unsurv/NFC_temp/README.md

# NFC_sense

available [here](https://shop.unsurv.org/)
