unsurv/NFC_temp/software/nfc_sense/old2/README.md

# RF430CL
Energia/Arduino library for TI RF430CL330H NFC Passive Tag
