unsurv/NFC_temp/hardware/nfc_sense_ntag/nfc_sense_ntag.png

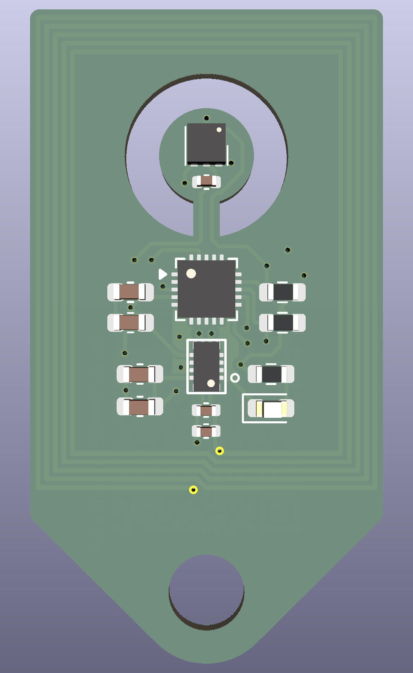
hardware/nfc_sense_ntag/nfc_sense_ntag.png
