unsurv/NFC_temp/hardware/nfc_sense_ntag/nfc_sense_ntag_custom_view.png

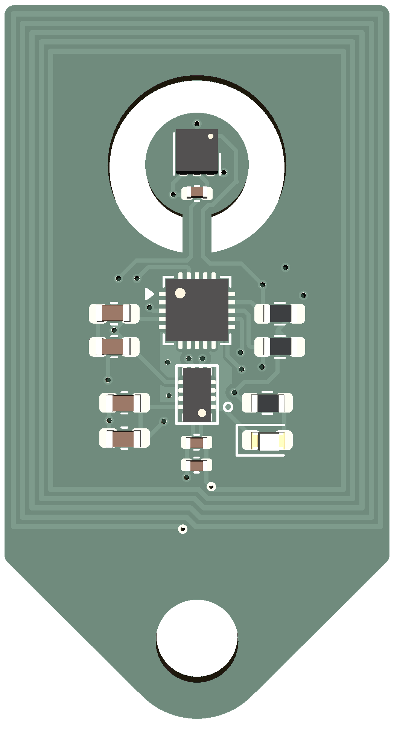
hardware/nfc_sense_ntag/nfc_sense_ntag_custom_view.png
