unsurv/NFC_temp/hardware/tools/nfc_sense_prgramming/case/nfc_sense.png

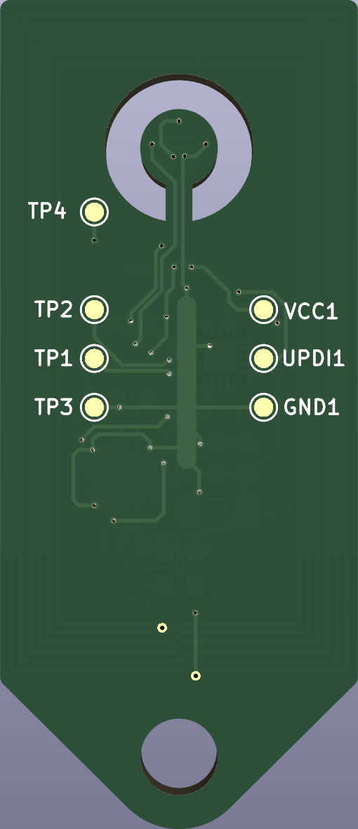
hardware/tools/nfc_sense_prgramming/case/nfc_sense.png
