unsurv/NFC_temp/software/arduino_settings.PNG

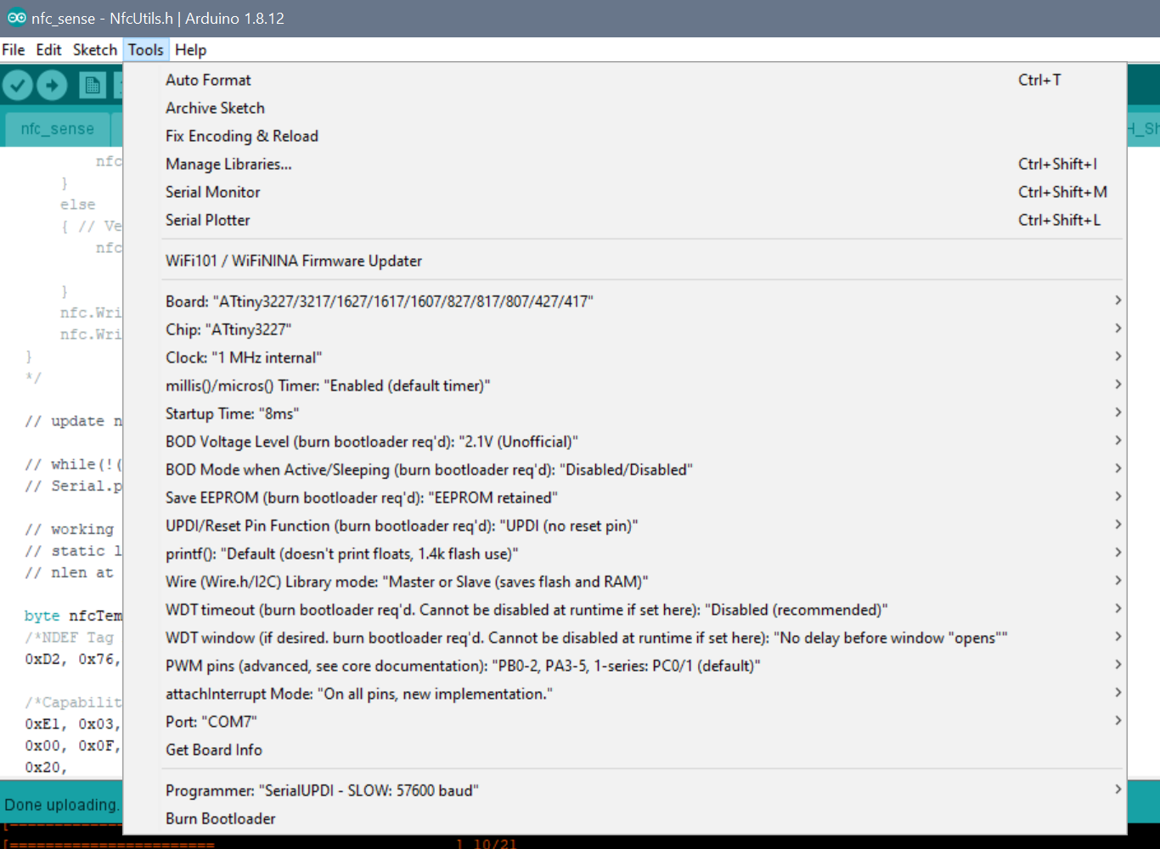
software/arduino_settings.PNG
