unsurv/NFC_temp/hardware/tools/debug/3D/pocket_knife_scales-pocket_knife_uppermain.stl

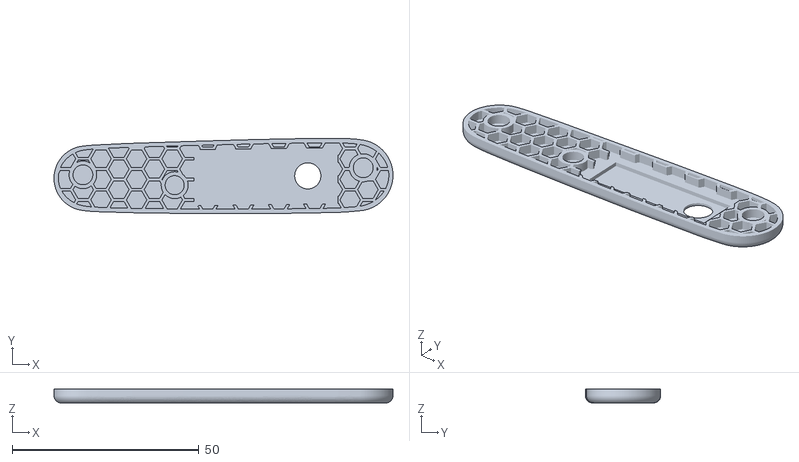
[picture p5: CAD file, 2025-08-21]
hardware/tools/debug/3D/pocket_knife_scales-pocket_knife_uppermain.stl
90.7 x 20.2 x 3.75
