unsurv/NFC_temp/hardware/case/nfc_case_simple_ntag.FCStd

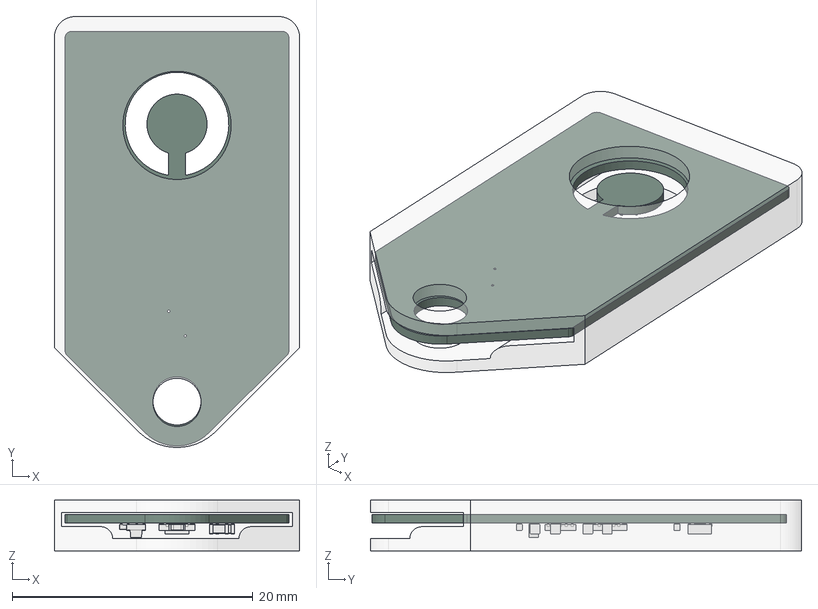
[picture p6: CAD file, 2026-08-13]
hardware/case/nfc_case_simple_ntag.FCStd
20.4 x 35.8 x 4.20 mm
simple_case
C_0603_1608Metric018
C_0603_1608Metric020
C_0603_1608Metric022
WSON_6_1EP_2x2mm_P065mm_EP1x16mm002
LED_0603_1608Metric002
UQFN-20-1EP_3x3mm_Pitch0.4mm001
R_0603_1608Metric012
C_0402_1005Metric010
UDFN_10_135x26mm_Pitch05mm
C_0402_1005Metric012
R_0603_1608Metric014
R_0603_1608Metric016
C_0603_1608Metric024
C_0402_1005Metric014
nfc_sense_ntag_PCB001
