unsurv/NFC_temp/hardware/nfc_pocket_knife/nfc_sense.step

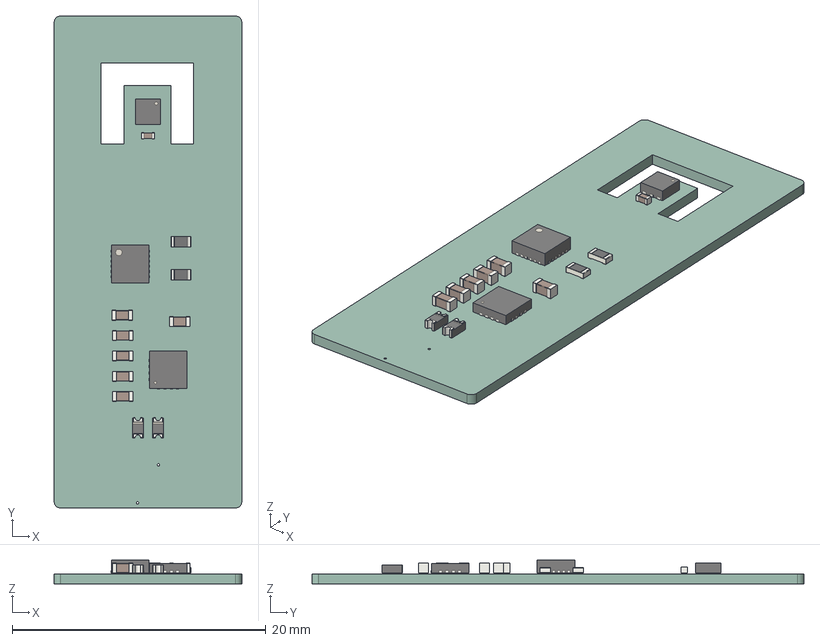
[picture p7: CAD file, 2025-06-03]
hardware/nfc_pocket_knife/nfc_sense.step
14.8 x 38.8 x 1.86 mm
C_0603_1608Metric x 6
QFN-16-1EP_3x3mm_P0.5mm_EP1.7x1.7mm
WSON_6_1EP_2x2mm_P065mm_EP1x16mm
QFN-24_3x3mm_Pitch0.4mm
D_0603 x 2
R_0603_1608Metric x 2
C_0402_1005Metric
victorinox_sense_PCB
