unsurv/NFC_temp/hardware/nfc_sense_attiny/nfc_sense.step

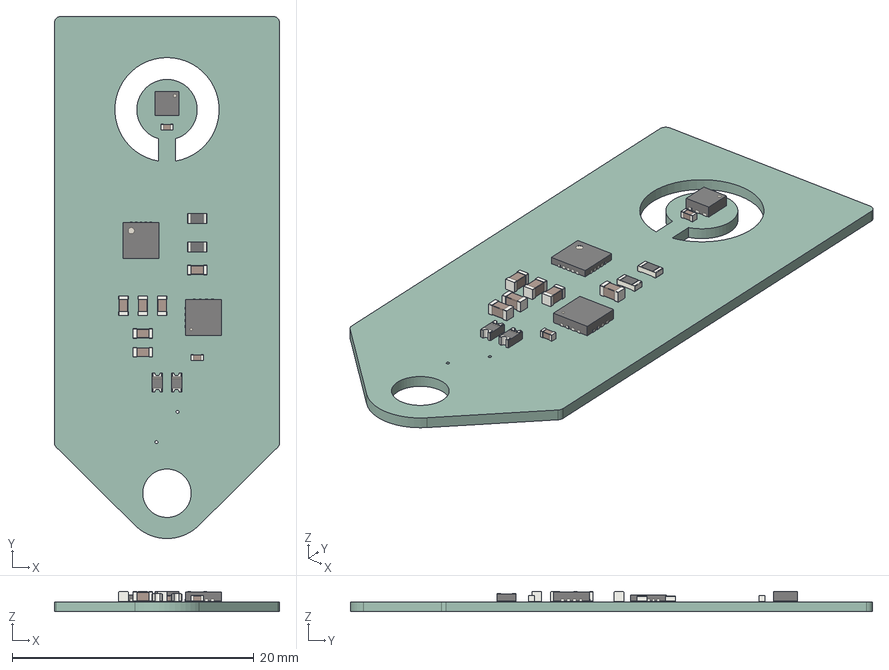
[picture p8: CAD file, 2024-11-09]
hardware/nfc_sense_attiny/nfc_sense.step
18.6 x 43.1 x 1.66 mm
C_0603_1608Metric x 6
QFN-16-1EP_3x3mm_P0.5mm_EP1.7x1.7mm
WSON_6_1EP_2x2mm_P065mm_EP1x16mm
UQFN-20-1EP_3x3mm_Pitch0.4mm
D_0603 x 2
R_0603_1608Metric x 2
C_0402_1005Metric x 2
nfc_sense_PCB
