unsurv/NFC_temp/hardware/nfc_sense_ntag/nfc_sense_ntag.step

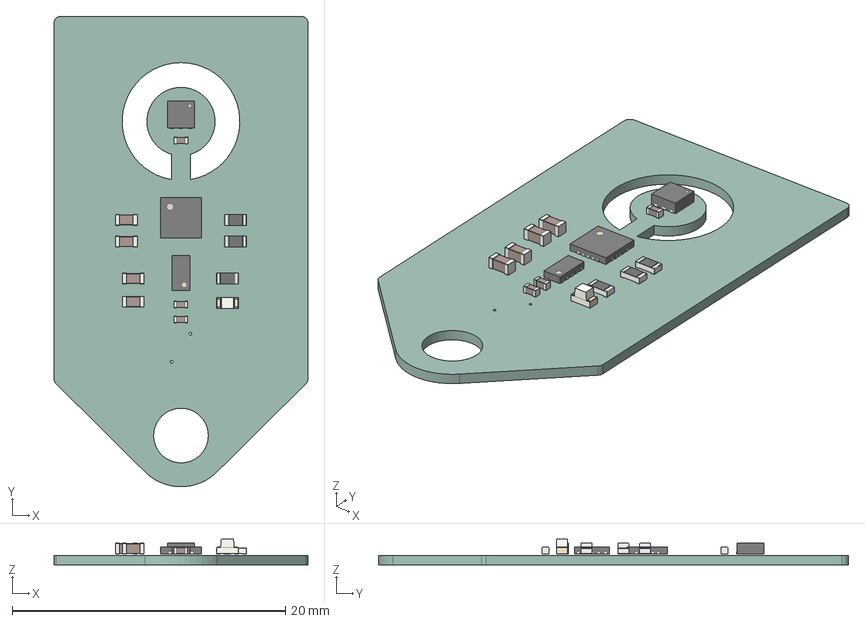
[picture p9: CAD file, 2026-08-13]
hardware/nfc_sense_ntag/nfc_sense_ntag.step
18.6 x 34.4 x 1.90 mm
C_0603_1608Metric x 4
WSON_6_1EP_2x2mm_P065mm_EP1x16mm
LED_0603_1608Metric
UQFN-20-1EP_3x3mm_Pitch0.4mm
R_0603_1608Metric x 3
C_0402_1005Metric x 3
UDFN_10_135x26mm_Pitch05mm
nfc_sense_ntag_PCB
