unsurv/NFC_temp/hardware/nfc_sense_ntag_surface/nfc_sense_ntag_surface.step

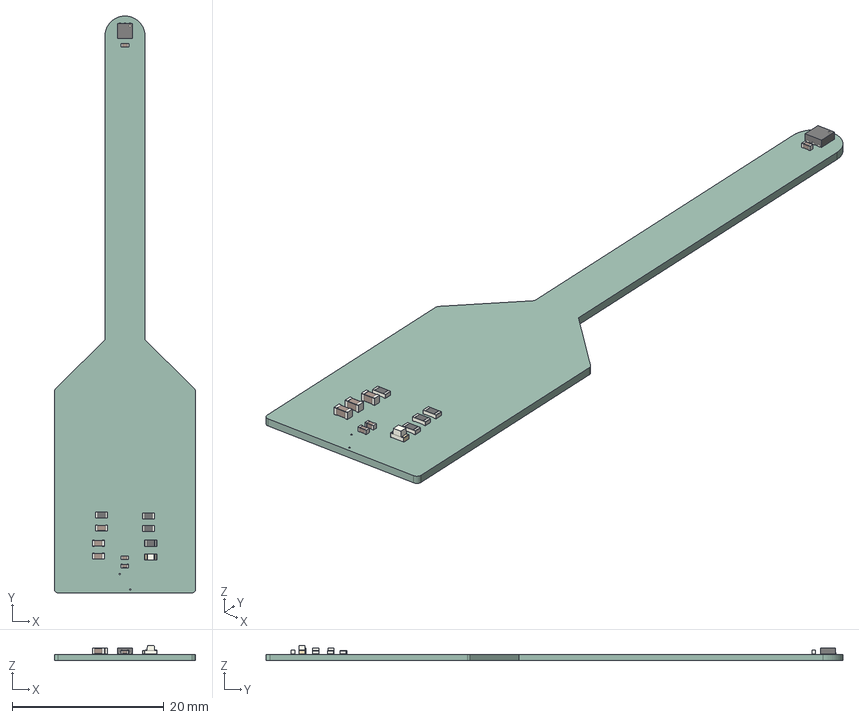
[picture p10: CAD file, 2025-11-26]
hardware/nfc_sense_ntag_surface/nfc_sense_ntag_surface.step
18.6 x 76.0 x 1.94 mm
C_0603_1608Metric x 3
WSON_6_1EP_2x2mm_P065mm_EP1x16mm
LED_0603_1608Metric
R_0603_1608Metric x 4
C_0402_1005Metric x 3
nfc_sense_ntag_surface_PCB
