unsurv/NFC_temp/hardware/tools/debug/3D/pocket_knife_scales.FCStd

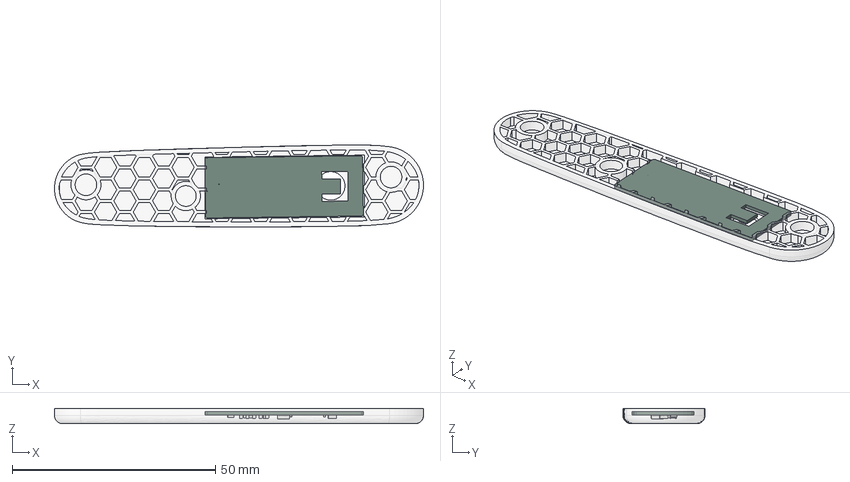
[picture p11: CAD file, 2025-09-21]
hardware/tools/debug/3D/pocket_knife_scales.FCStd
90.7 x 20.2 x 3.75 mm
main
C_0603_1608Metric012
C_0603_1608Metric014
C_0603_1608Metric016
C_0603_1608Metric018
QFN-16-1EP_3x3mm_P0.5mm_EP1.7x1.7mm002
WSON_6_1EP_2x2mm_P065mm_EP1x16mm001
C_0603_1608Metric020
QFN-24_3x3mm_Pitch0.4mm001
C_0603_1608Metric022
D_0605
R_0603_1608Metric004
C_0402_1005Metric002
R_0603_1608Metric006
D_0606
victorinox_sense_PCB001
