unsurv/NFC_temp/hardware/tools/nfc_sense_prgramming/case/programming_case_ntag.FCStd

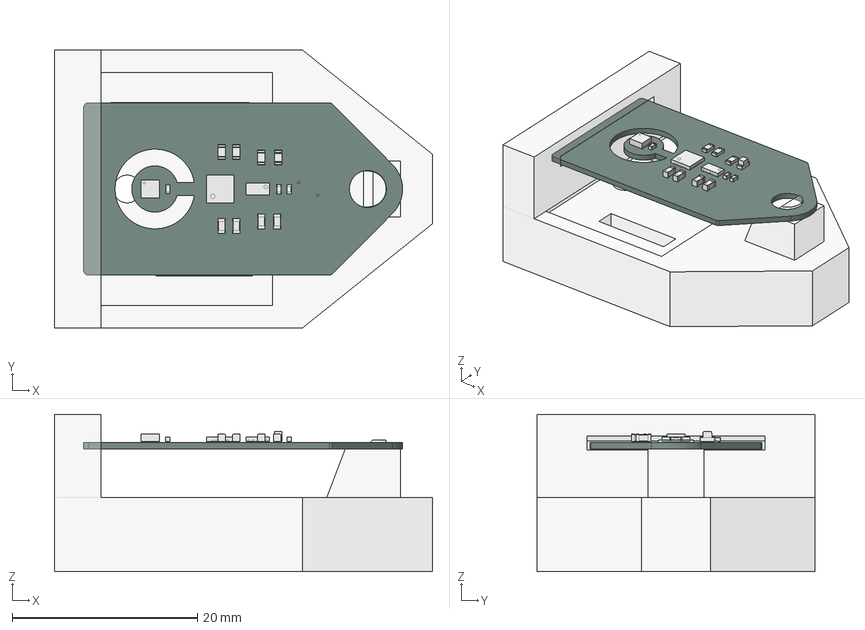
[picture p12: CAD file, 2026-08-11]
hardware/tools/nfc_sense_prgramming/case/programming_case_ntag.FCStd
40.8 x 30.0 x 17.0 mm
C_0603_1608Metric004
C_0603_1608Metric006
C_0603_1608Metric008
WSON_6_1EP_2x2mm_P065mm_EP1x16mm
LED_0603_1608Metric
UQFN-20-1EP_3x3mm_Pitch0.4mm
R_0603_1608Metric002
C_0402_1005Metric002
UDFN_10_135x26mm_Pitch05mm
C_0402_1005Metric004
R_0603_1608Metric004
R_0603_1608Metric006
C_0603_1608Metric010
C_0402_1005Metric006
nfc_sense_ntag_PCB
