unsurv/NFC_temp/hardware/tools/stencil_helper/stencil_spacer_machine.FCStd

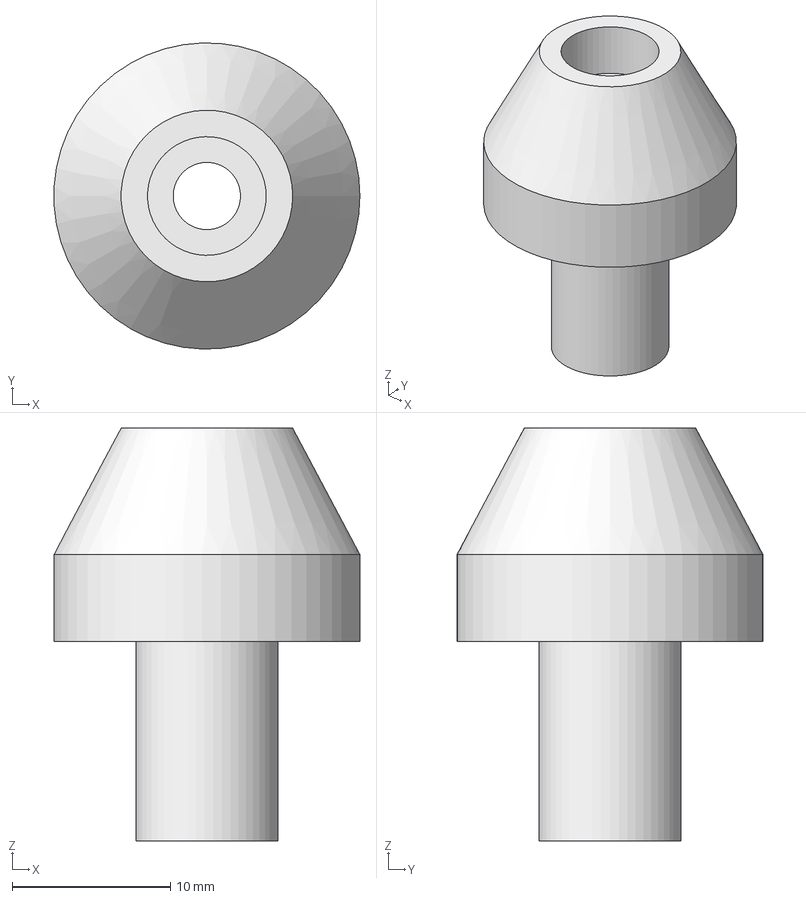
[picture p13: CAD file, 2026-08-11]
hardware/tools/stencil_helper/stencil_spacer_machine.FCStd
19.3 x 19.3 x 26.1 mm
