unsurv/NFC_temp/hardware/case/nfc_case_simple_ntag-simple_case.stl

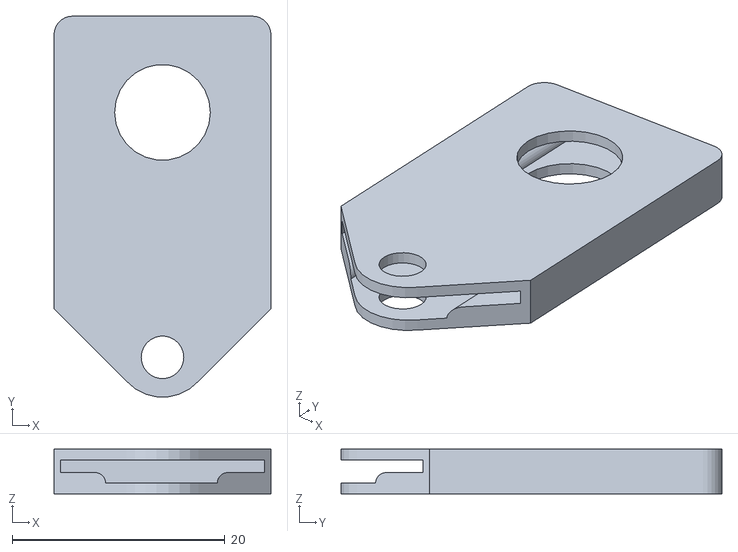
[picture p14: CAD file, 2026-08-13]
hardware/case/nfc_case_simple_ntag-simple_case.stl
20.4 x 35.8 x 4.20
