unsurv/NFC_temp/hardware/tools/nfc_sense_prgramming/case/programming_case_ntag-Body.stl

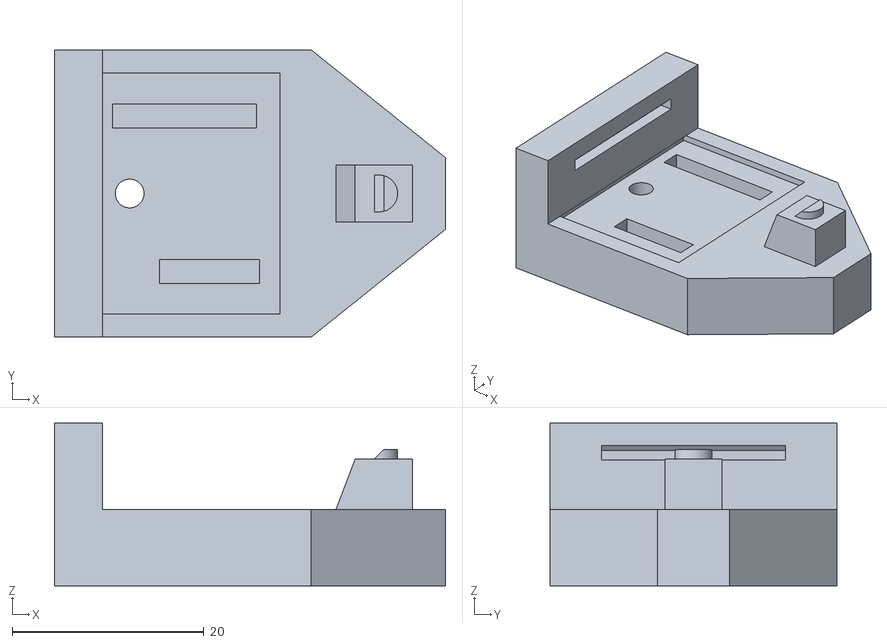
[picture p15: CAD file, 2026-08-11]
hardware/tools/nfc_sense_prgramming/case/programming_case_ntag-Body.stl
40.8 x 30.0 x 17.0
