unsurv/NFC_temp/hardware/tools/stencil_helper/stencil_spacers.FCStd

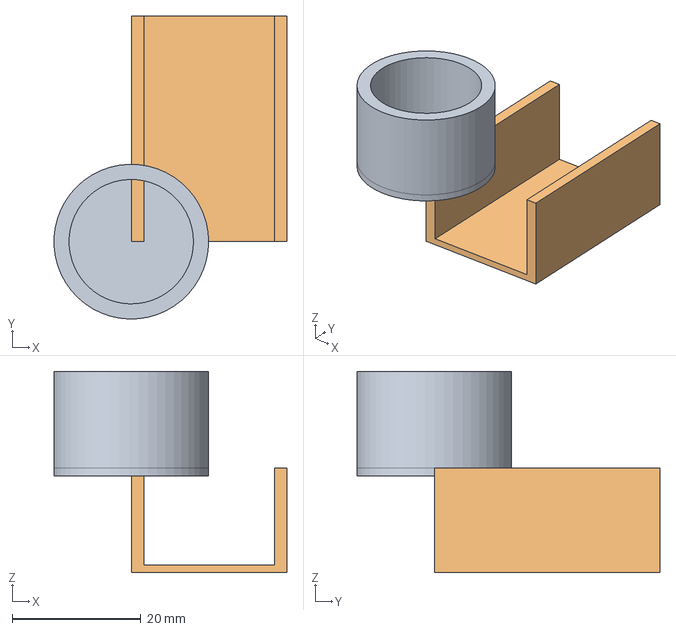
[picture p16: CAD file, 2026-08-11]
hardware/tools/stencil_helper/stencil_spacers.FCStd
36.1 x 47.0 x 31.2 mm
round_spacer
rect_spacer
