unsurv/NFC_temp/hardware/case/thermal_sleeve.FCStd

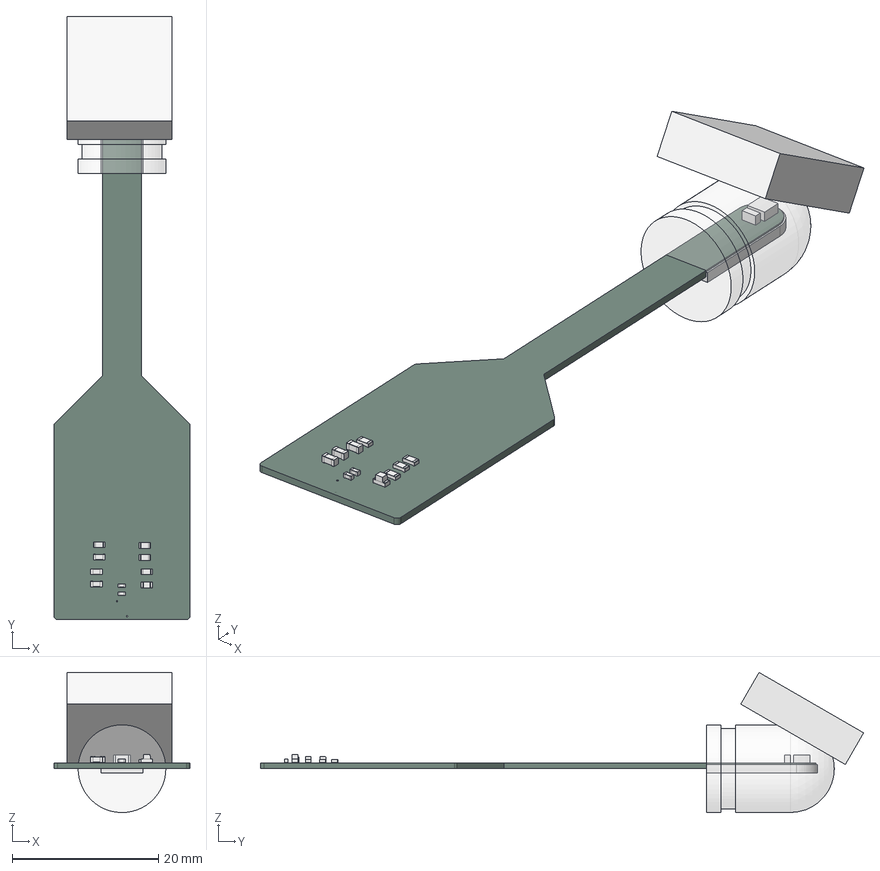
[picture p17: CAD file, 2025-11-26]
hardware/case/thermal_sleeve.FCStd
18.6 x 82.5 x 19.2 mm
temperature_sleeve
PCB_cutout
surface_edge
C_0603_1608Metric006
C_0603_1608Metric008
WSON_6_1EP_2x2mm_P065mm_EP1x16mm001
LED_0603_1608Metric002
R_0603_1608Metric008
C_0402_1005Metric006
R_0603_1608Metric010
C_0402_1005Metric008
R_0603_1608Metric012
R_0603_1608Metric014
C_0603_1608Metric010
C_0402_1005Metric010
nfc_sense_ntag_surface_PCB
