unsurv/NFC_temp/hardware/case/nfc_stand.FCStd

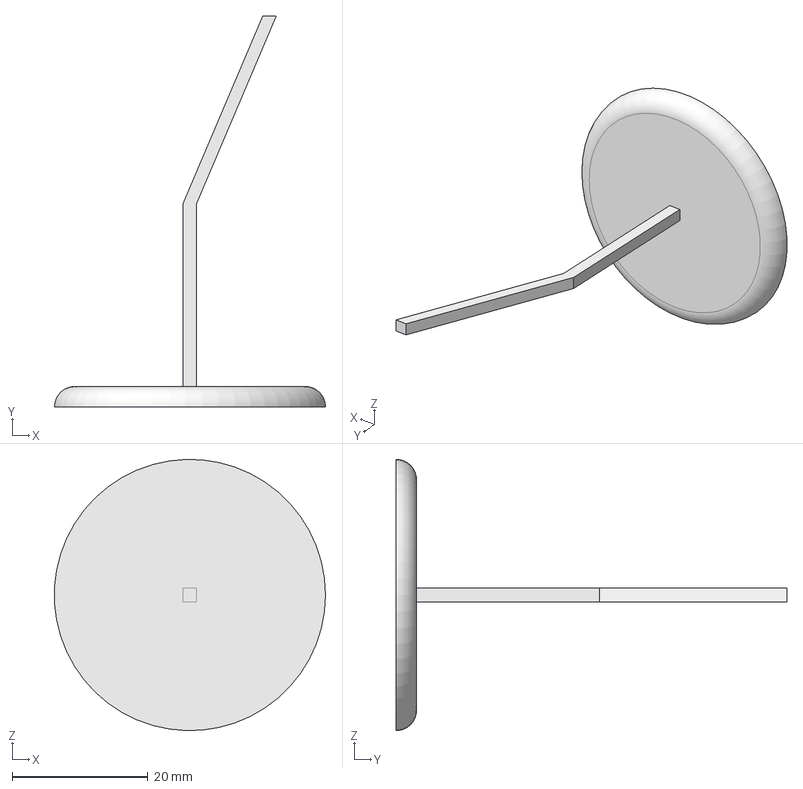
[picture p18: CAD file, 2025-08-21]
hardware/case/nfc_stand.FCStd
40.0 x 57.6 x 40.0 mm
