unsurv/NFC_temp/hardware/tools/nfc_sense_prgramming/case/programming_case_0_8mm.FCStd

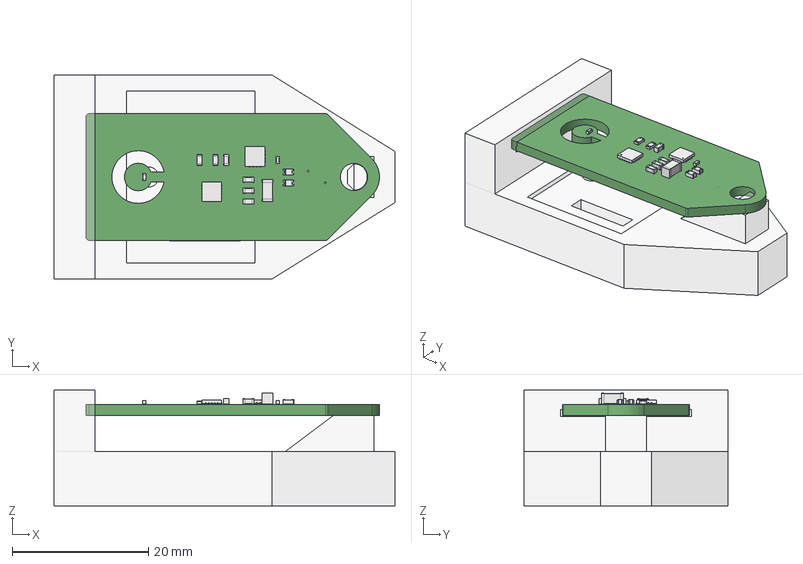
[picture p19: CAD file, 2026-07-31]
hardware/tools/nfc_sense_prgramming/case/programming_case_0_8mm.FCStd
50.1 x 30.0 x 17.0 mm
nfc_sense PCB
