unsurv/NFC_temp/hardware/tools/stencil_helper/stencil_spacers-Partround_spacer.stl

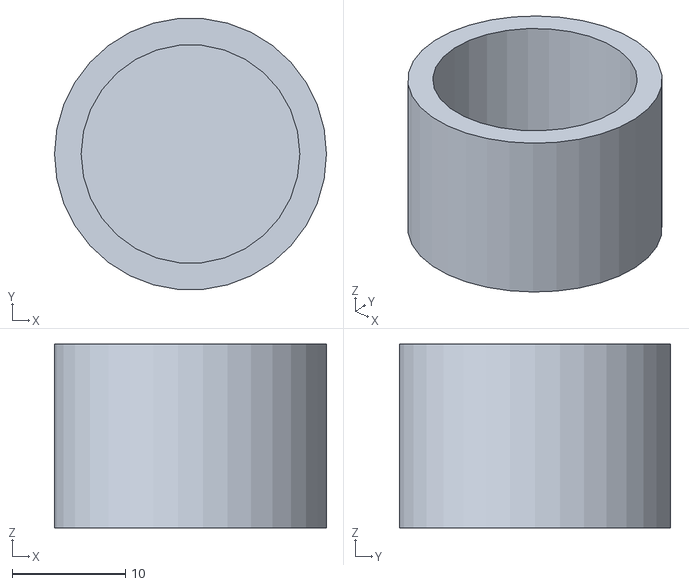
[picture p20: CAD file, 2026-08-11]
hardware/tools/stencil_helper/stencil_spacers-Partround_spacer.stl
24.0 x 23.9 x 16.2
