unsurv/NFC_temp/hardware/tools/nfc_sense_prgramming/case/nfc_sense_prgramming.step

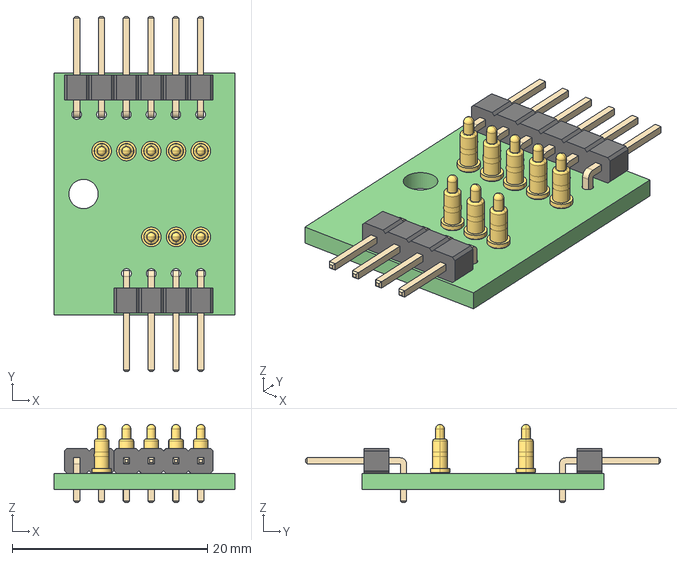
[picture p21: CAD file, 2024-11-20]
hardware/tools/nfc_sense_prgramming/case/nfc_sense_prgramming.step
18.5 x 36.4 x 8.00 mm
nfc_sense_prgramming PCB
