unsurv/NFC_temp/hardware/tools/stencil_helper/stencil_spacers-Partrect_spacer.stl

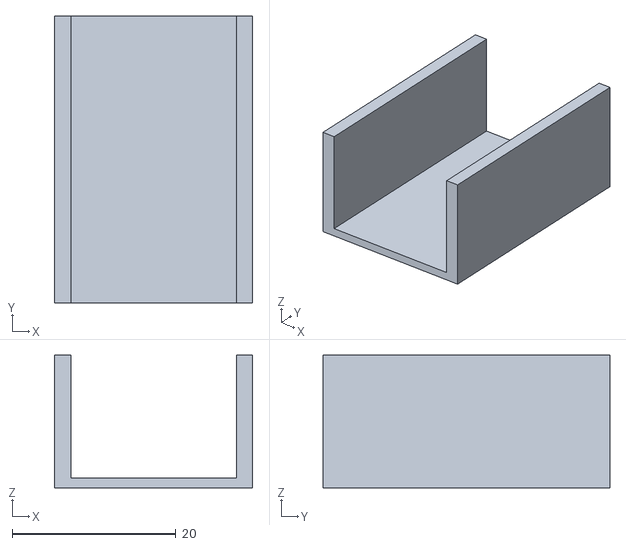
[picture p22: CAD file, 2026-08-11]
hardware/tools/stencil_helper/stencil_spacers-Partrect_spacer.stl
24.1 x 35.0 x 16.2
