unsurv/NFC_temp/hardware/case/nfc_case_simple-simple_case.3mf

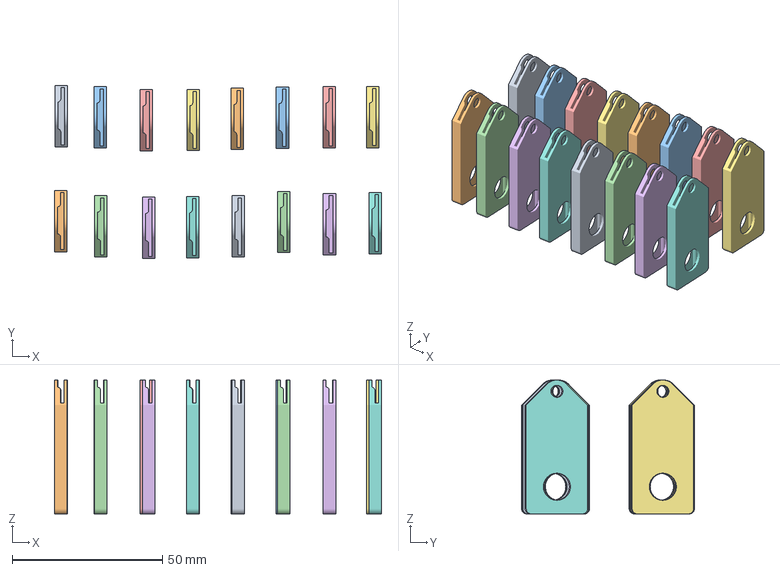
[picture p23: CAD file, 2024-12-10]
hardware/case/nfc_case_simple-simple_case.3mf
108.7 x 57.5 x 44.5 mm
