unsurv/NFC_temp/hardware/tools/nfc_sense_prgramming/case/programming_case.FCStd

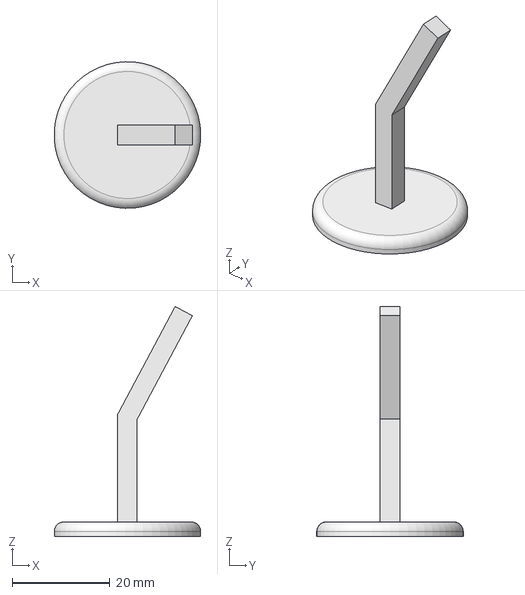
[picture p24: CAD file, 2024-11-20]
hardware/tools/nfc_sense_prgramming/case/programming_case.FCStd
30.0 x 30.0 x 47.1 mm
