unsurv/NFC_temp/hardware/tools/stencil_helper/aisler_stencil_helper_small-Body.stl

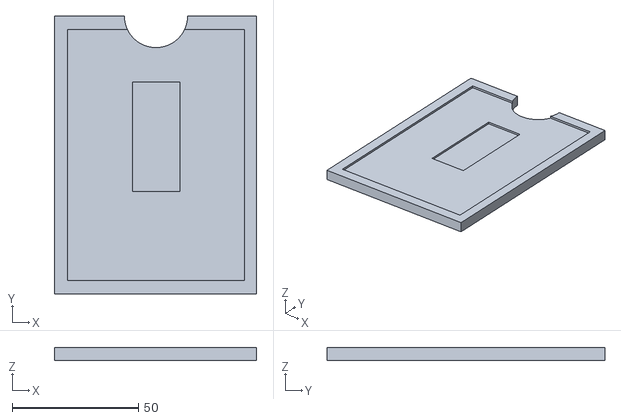
[picture p27: CAD file, 2024-12-03]
hardware/tools/stencil_helper/aisler_stencil_helper_small-Body.stl
80.0 x 110.0 x 5.00
