unsurv/NFC_temp/hardware/case/nfc_case.FCStd

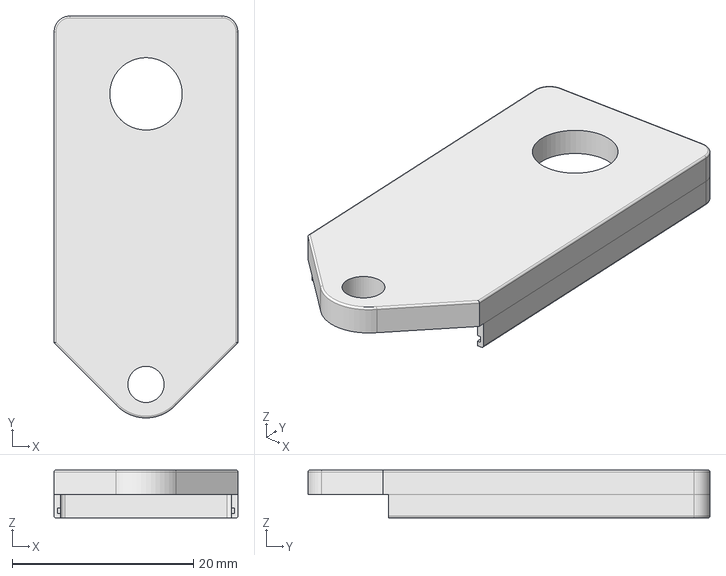
[picture p28: CAD file, 2024-10-31]
hardware/case/nfc_case.FCStd
20.3 x 44.4 x 5.30 mm
