unsurv/NFC_temp/hardware/tools/nfc_sense_prgramming/case/programming_case_0_8mm-Body.stl

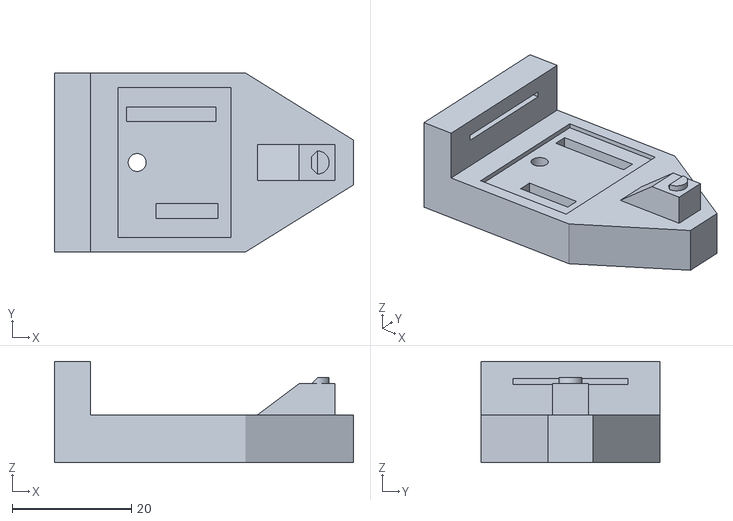
[picture p29: CAD file, 2024-11-20]
hardware/tools/nfc_sense_prgramming/case/programming_case_0_8mm-Body.stl
50.1 x 30.0 x 17.0
