unsurv/NFC_temp/hardware/tools/stencil_helper/aisler_stencil_helper-Body.stl

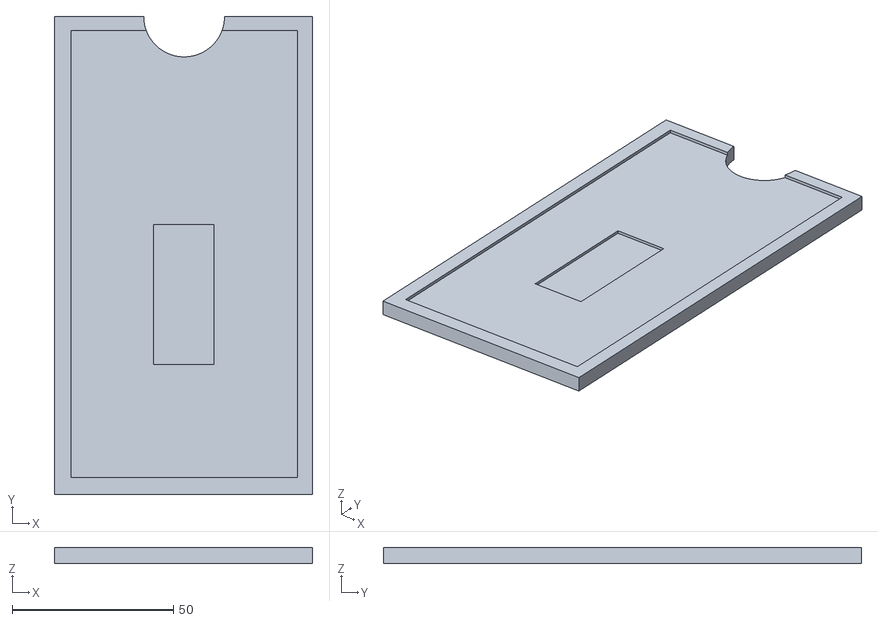
[picture p30: CAD file, 2024-11-09]
hardware/tools/stencil_helper/aisler_stencil_helper-Body.stl
80.0 x 148.0 x 5.00
