unsurv/NFC_temp/hardware/tools/stencil_helper/aisler_stencil_helper.FCStd

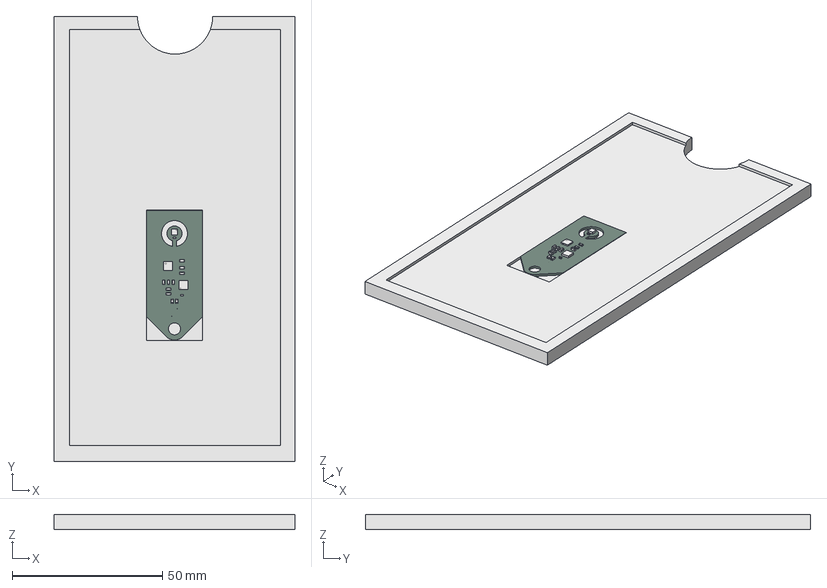
[picture p31: CAD file, 2024-11-09]
hardware/tools/stencil_helper/aisler_stencil_helper.FCStd
80.0 x 148.0 x 5.00 mm
C_0603_1608Metric
C_0603_1608Metric002
C_0603_1608Metric004
C_0603_1608Metric006
QFN-16-1EP_3x3mm_P0.5mm_EP1.7x1.7mm
WSON_6_1EP_2x2mm_P065mm_EP1x16mm
C_0603_1608Metric008
UQFN-20-1EP_3x3mm_Pitch0.4mm
C_0603_1608Metric010
D_0603
R_0603_1608Metric
C_0402_1005Metric
C_0402_1005Metric002
R_0603_1608Metric002
D_0604
nfc_sense_PCB
