unsurv/NFC_temp/hardware/case/nfc_case-top_case.3mf

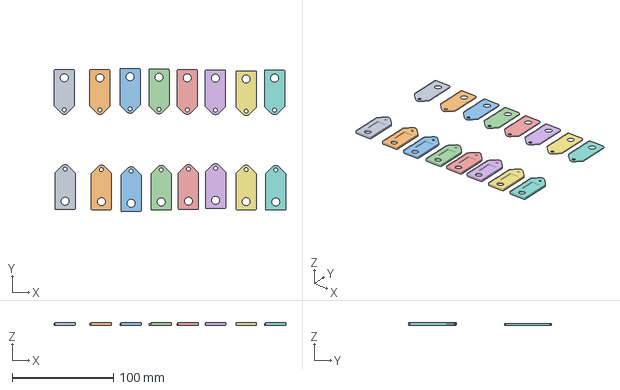
[picture p32: CAD file, 2024-09-28]
hardware/case/nfc_case-top_case.3mf
229.7 x 141.6 x 3.30 mm
nfc_case_FDM-top_case_FDM.stl
nfc_case_FDM-bottom_case_FDM.stl
