unsurv/NFC_temp/hardware/case/nfc_case_FDM.FCStd

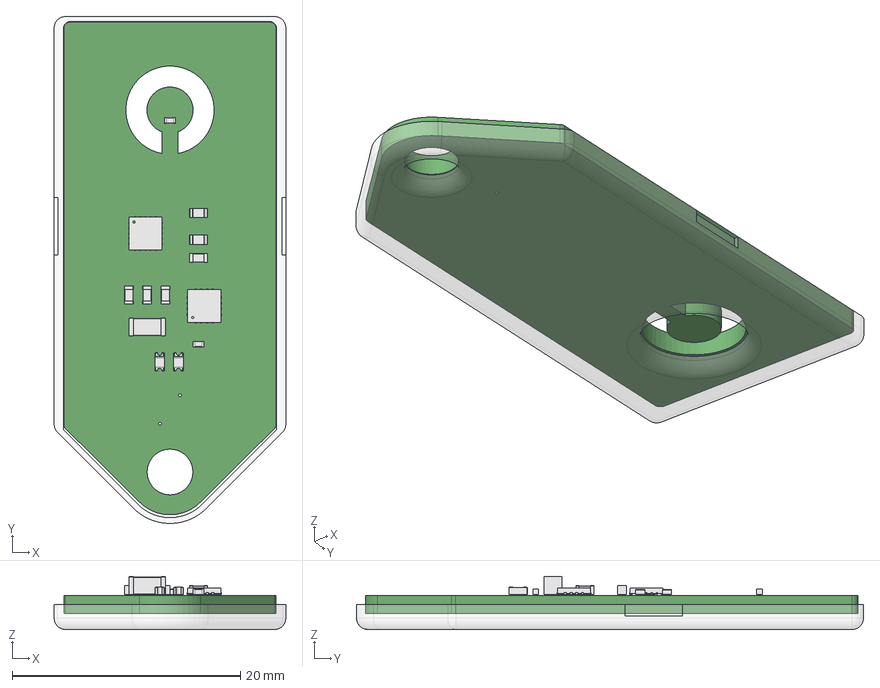
[picture p33: CAD file, 2024-09-28]
hardware/case/nfc_case_FDM.FCStd
20.3 x 44.4 x 4.65 mm
nfc_sense PCB
bottom_case_FDM
