unsurv/NFC_temp/(list of files, cad)

Other CAD files:
hardware/nfc_sense_ntag_BME2/nfc_sense_ntag_BME.step
hardware/tools/nfc_sense_prgramming/case/nfc_sense_ntag.step
hardware/tools/stencil_helper/stencil_spacer_machine-PartBody.stl
hardware/case/nfc_stand-PartBody.stl
hardware/tools/nfc_sense_prgramming/case/holder.stl
hardware/tools/nfc_sense_prgramming/case/programming_case-Body.stl
hardware/case/nfc_case-top_case.stl
hardware/case/nfc_case_simple-simple_case.stl
