unsurv/NFC_temp/software/nfc_sense_ntag_debug/nfc_sense_ntag_debug/ide_settings.PNG

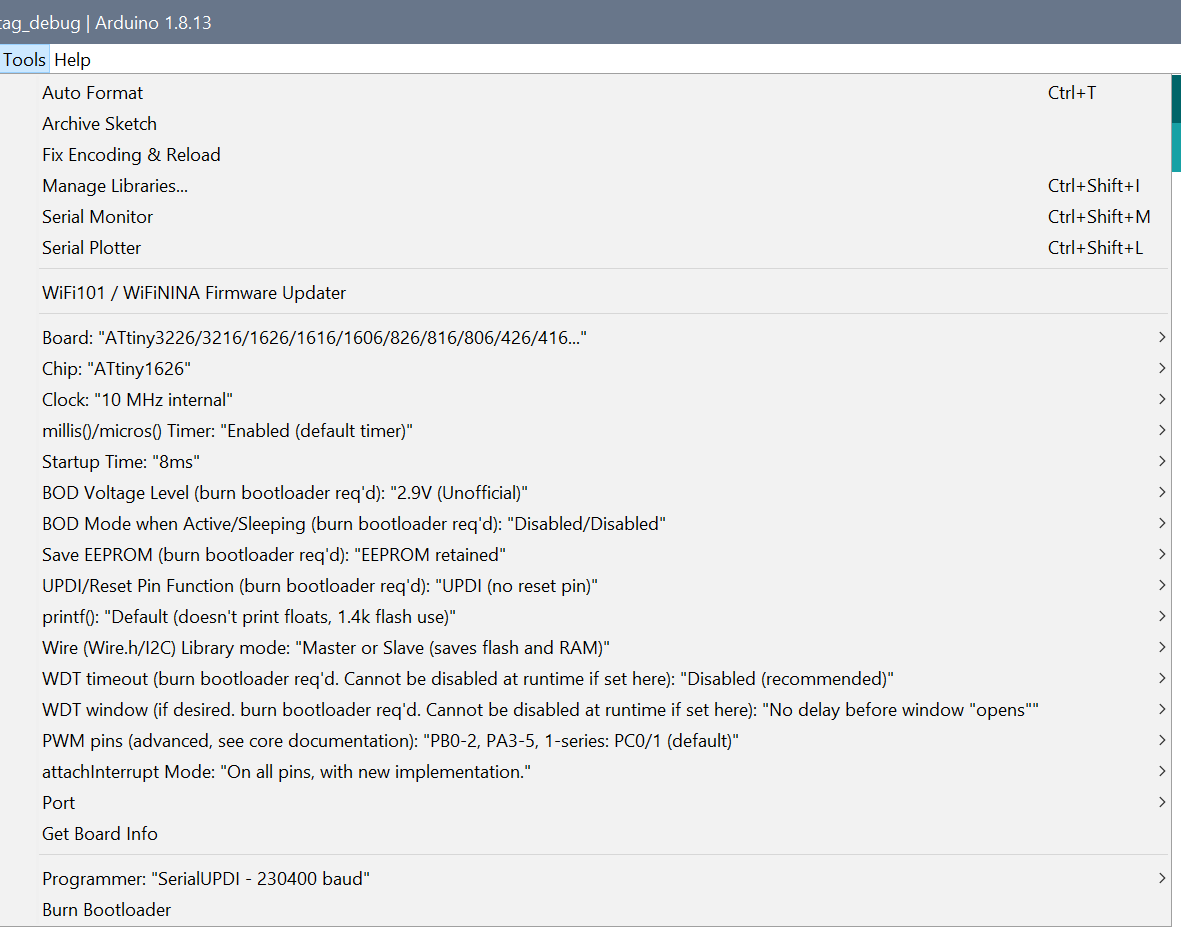
software/nfc_sense_ntag_debug/nfc_sense_ntag_debug/ide_settings.PNG
