unsurv/NFC_temp/hardware/tools/debug/schematic.pdf

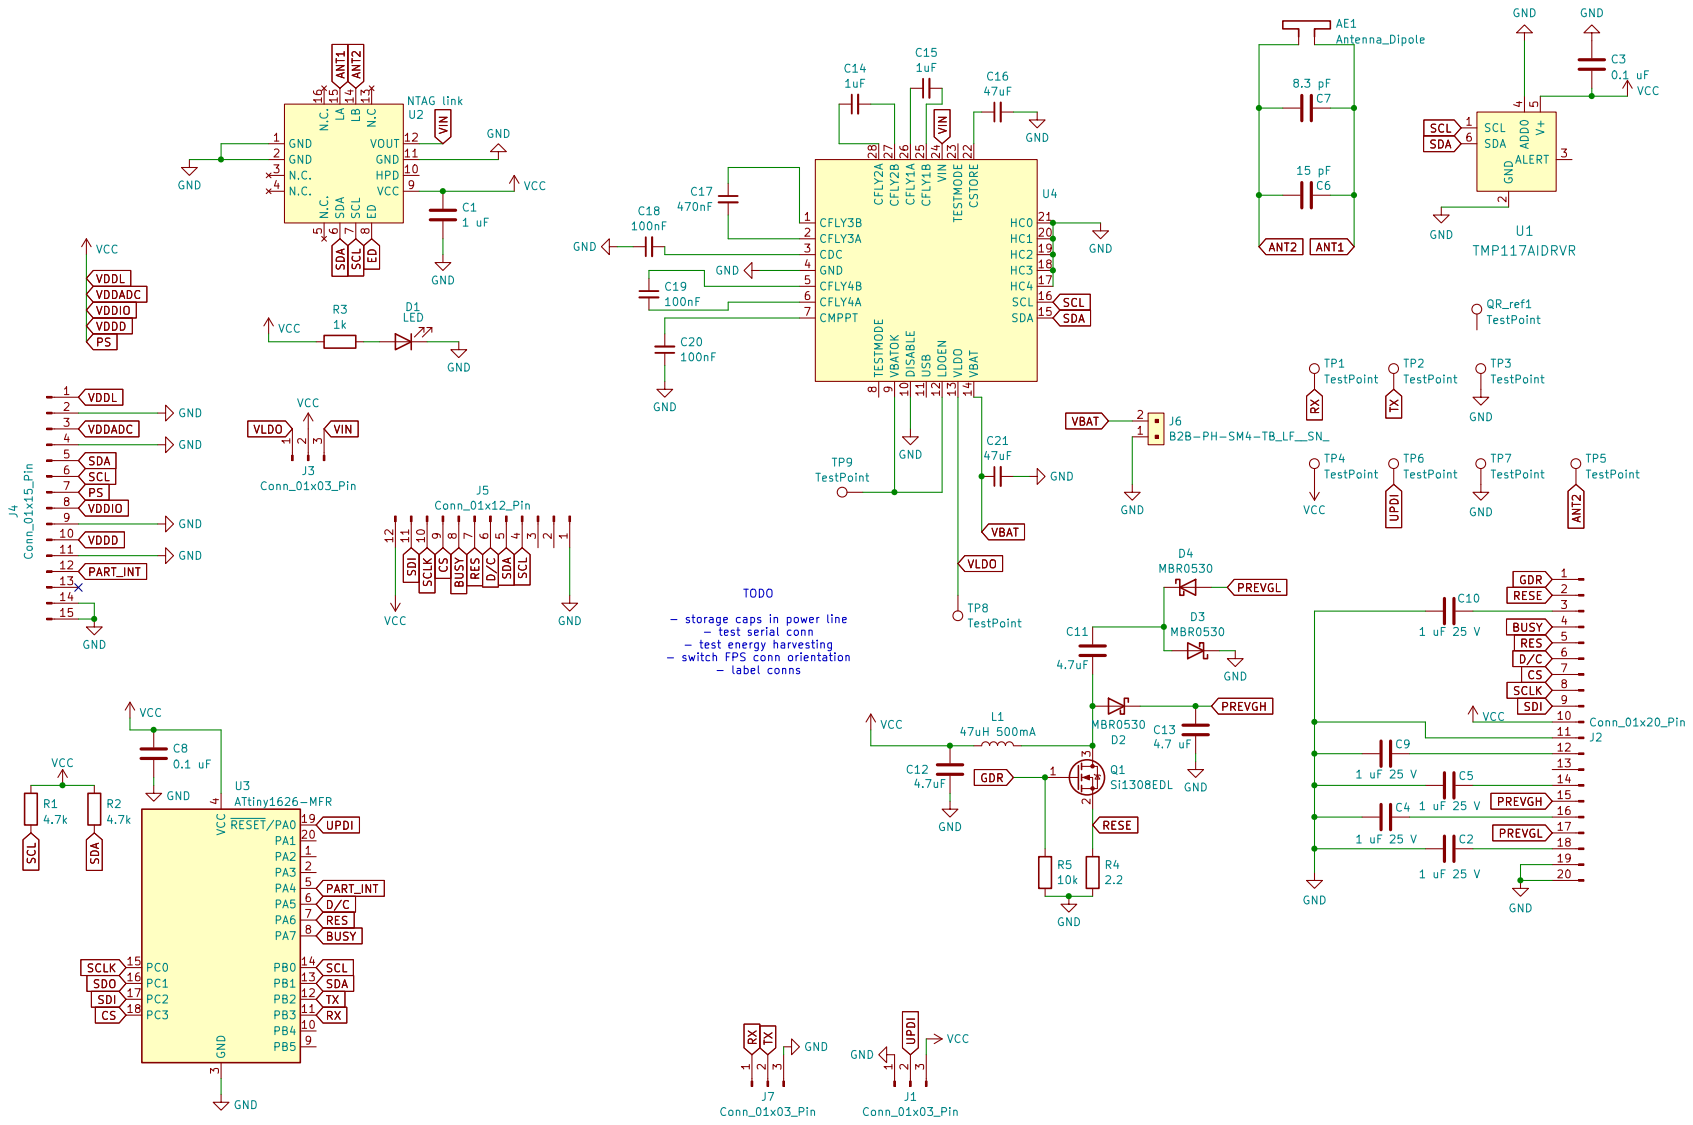
[picture p35: page 1]
