unsurv/NFC_temp/(commit log)

2023-10-08 half bridge rectifier version
    [nfc_sense.kicad_pcb, nfc_sense.kicad_sch]
2023-10-17 added second tuning cap
    [nfc_sense.kicad_pcb, nfc_sense.kicad_sch]
2023-12-18 move temp sensor to digital
    [nfc_sense.kicad_pcb, nfc_sense.kicad_sch]
2023-12-19 revert to 35 mm x 18 mm antenna
    [nfc_sense.kicad_pcb, nfc_sense.kicad_sch]
2024-01-18 add software working on android only
    [nfc_case.FCStd, nfc_sense.kicad_pcb, nfc_sense.kicad_sch, nfc_sense.step]
2024-01-19 working iOS + android
    [nfc_case.FCStd, nfc_sense.kicad_pcb, nfc_sense.kicad_sch, nfc_sense.step]
2024-01-19 triangle extension
    [nfc_sense.kicad_sch]
2024-01-19 triangle shape
    [nfc_sense.kicad_pcb]
2024-01-20 attiny426 revision
    [nfc_sense.kicad_pcb, nfc_sense.kicad_sch]
2024-02-06 changed to attiny 1626
    [nfc_case-bottom_case.stl, nfc_case-top_case_cut.3mf, nfc_case-top_case_cut.stl, nfc_case.FCStd, nfc_sense.kicad_pcb, nfc_sense.kicad_sch]
2024-02-25 individual case part cutouts
    [nfc_case-bottom_case.stl, nfc_case-top_case.stl, nfc_case-top_case_cut.3mf, nfc_case-top_case_cut.stl, nfc_case.FCStd, nfc_sense.kicad_pcb, nfc_sense.kicad_sch, nfc_sense.step]
2024-03-29 add improvements + Fahrenheit conversion
    [nfc_case-bottom_case.stl, nfc_case-top_case.stl, nfc_case.FCStd]
2024-04-20 add filament case
    [nfc_case-bottom_case.stl, nfc_case-top_case.3mf, nfc_case.FCStd, nfc_case_FDN.FCStd]
2024-09-28 rev 2
    [nfc_case-top_case.3mf, nfc_case-top_case.stl, nfc_case.FCStd, nfc_case_FDM-bottom_case_FDM.stl, nfc_case_FDM-top_case_FDM.stl, nfc_case_FDM.FCStd, nfc_case_FDN.FCStd, nfc_sense.kicad_pcb]
2024-10-31 kicad 8 + panelization
    [nfc_case.FCStd, nfc_case_simple-simple_case.stl, nfc_case_simple.FCStd, nfc_sense.kicad_pcb, nfc_sense.kicad_sch, nfc_sense.step, nfc_sense_panel.kicad_pcb]
2024-11-01 penel mousebite spacing
    [nfc_sense_panel.kicad_pcb]
2024-11-03 desc + new TP
    [nfc_sense.kicad_pcb, nfc_sense.kicad_sch]
2024-11-03 new panel frame
    [nfc_sense.kicad_pcb, nfc_sense_panel.kicad_pcb]
2024-11-08 change to 100uf tantalum for power siphoning
    [aisler_stencil_helper.FCStd, nfc_sense.kicad_sch]
2024-11-09 stencil helper updates
    [aisler_stencil_helper-Body.stl, aisler_stencil_helper.FCStd, nfc_sense.step]
2024-11-15 change footprints for better paste application
    [nfc_case_simple.FCStd, nfc_sense.kicad_sch]
2024-11-15 update labeling
    [nfc_sense.kicad_pcb]
2024-11-15 new panel
    [nfc_sense_panel.kicad_pcb]
2024-11-20 add programming jig
    [aisler_stencil_helper-Body.stl, aisler_stencil_helper.FCStd, holder.stl, nfc_sense_prgramming.kicad_pcb, nfc_sense_prgramming.kicad_sch, nfc_sense_prgramming.step, programming_case-Body.stl, programming_case.FCStd]
2024-11-21 update design to prevent manufacturing errors
    [nfc_sense.kicad_pcb]
2024-11-21 update traces for better manufacturing
    [nfc_sense.kicad_pcb]
2024-11-21 update DRC for 0.8 mm
    [nfc_sense.kicad_pcb]
2024-11-21 update panel + panel settings
    [nfc_sense_panel.kicad_pcb]
2024-11-22 update RF430 footprint
    [nfc_sense.kicad_pcb, nfc_sense.kicad_sch]
2024-11-26 create small stencil helper
    [aisler_stencil_helper_small-Body.stl, aisler_stencil_helper_small.FCStd]
2024-12-03 update small stencil helper
    [aisler_stencil_helper_small-Body.stl, aisler_stencil_helper_small.FCStd, nfc_case_simple-simple_case.stl, nfc_case_simple.FCStd]
2024-12-03 update cutout for 0.8mm case
    [nfc_case_simple.FCStd]
2024-12-05 start 1 Euro coin version
    [nfc_sense_coin.kicad_pcb, nfc_sense_coin.kicad_sch]
2024-12-05 preliminary routing on coin
    [nfc_sense_coin.kicad_pcb, nfc_sense_coin.kicad_sch]
2024-12-06 coin routing improvements
    [nfc_sense_coin.kicad_pcb]
2024-12-09 update simple case cutout STL file
    [nfc_case_simple-simple_case.stl, nfc_case_simple.FCStd]
2024-12-10 update coin design
    [nfc_case_simple-simple_case.3mf, nfc_sense_coin.kicad_pcb]
2024-12-12 edit circular NFC antenna for Aisler production
    [nfc_sense_coin.kicad_pcb, nfc_sense_coin.kicad_sch]
2025-04-17 add SAK version
    [nfc_sense.step, victorinox_scales.FCStd, victorinox_sense.kicad_pcb, victorinox_sense.kicad_sch]
2025-04-17 mounting hole fitment
    [victorinox_scales-victorinox_upper.stl, victorinox_scales-victorinox_upper_less_fillet.stl, victorinox_scales.FCStd]
2025-05-04 update PCBs
    [nfc_sense.kicad_pcb, victorinox_scales-victorinox_uppermain.stl, victorinox_scales.FCStd]
2025-05-19 switch antenna layer
    [victorinox_scales-victorinox_uppermain.stl, victorinox_scales.FCStd, victorinox_sense.kicad_pcb]
2025-05-19 update 3D model
    [nfc_sense.step]
2025-05-21 flip antenna layer, fix ANT connection issues
    [victorinox_sense.kicad_pcb, victorinox_sense.kicad_sch]
2025-05-21 update 3D model PCB spacing
    [victorinox_scales-victorinox_uppermain.3mf, victorinox_scales-victorinox_uppermain.stl, victorinox_scales.FCStd]
2025-06-02 change thermometer cutout
    [nfc_sense_coin.kicad_pcb]
2025-06-02 add chain hole for nfc coin
    [nfc_sense_coin.kicad_pcb]
2025-06-03 correct PCB cutout for SAK version
    [nfc_sense.step, victorinox_scales-victorinox_uppermain.stl, victorinox_scales.FCStd]
2025-06-03 rename pocket knife version
    [nfc_sense.step, pocket_knife_scales-pocket_knife_uppermain.3mf, pocket_knife_scales-pocket_knife_uppermain.stl, pocket_knife_scales.FCStd, pocket_knife_sense.kicad_pcb, pocket_knife_sense.kicad_sch, victorinox_scales-victorinox_uppermain.3mf, victorinox_scales-victorinox_uppermain.stl]
2025-06-03 rename pt. II
    [victorinox_sense.kicad_pcb, victorinox_sense.kicad_sch]
2025-09-10 folder setup + ntag based sense
    [nfc_sense.kicad_pcb, nfc_sense.kicad_sch, nfc_sense.step, nfc_sense_ntag.kicad_pcb, nfc_sense_ntag.kicad_sch, nfc_sense_panel.kicad_pcb]
2025-09-15 ntag connections
    [nfc_sense_ntag.kicad_pcb, nfc_sense_ntag.kicad_sch]
2025-09-21 update 3D transparency for knife version
    [nfc_sense_ntag.kicad_pcb, nfc_sense_ntag.kicad_sch, pocket_knife_scales.FCStd]
2025-09-30 update footprint for NTAG
    [nfc_sense_ntag.kicad_pcb]
2025-10-04 update case for ntag version
    [nfc_case_simple_ntag.FCStd, nfc_sense_ntag.step]
2025-10-29 add BME multisensor version
    [nfc_sense_ntag_BME.kicad_pcb, nfc_sense_ntag_BME.kicad_sch]
2025-11-06 finalize iOS version
    [nfc_sense_ntag_BME.kicad_pcb]
2025-11-06 add pocket knife display version
    [pocket_knife_scales-pocket_knife_uppermain.stl, pocket_knife_scales.FCStd, pocket_knife_sense_display.kicad_pcb, pocket_knife_sense_display.kicad_sch]
2025-11-08 preparation for e ink display via FPC
    [pocket_knife_sense_display.kicad_pcb, pocket_knife_sense_display.kicad_sch]
2025-11-26 add surface temperature version
    [nfc_sense.kicad_pcb, nfc_sense_ntag_surface.kicad_pcb, nfc_sense_ntag_surface.kicad_sch, nfc_sense_ntag_surface.step, pocket_knife_sense_display.kicad_pcb, pocket_knife_sense_display.kicad_sch, thermal_sleeve.FCStd]
2025-12-30 add schematics for a debugging PCB
    [pocket_knife_scales-pocket_knife_uppermain.stl, pocket_knife_scales.FCStd, sense_debug.kicad_pcb, sense_debug.kicad_sch]
2026-01-08 preliminary placement for debug board
    [sense_debug.kicad_pcb, sense_debug.kicad_sch]
2026-01-13 route debug board
    [sense_debug.kicad_pcb, sense_debug.kicad_sch]
2026-04-06 new screen debug board
    [sense_debug.kicad_pcb, sense_debug.kicad_sch]
2026-04-10 update SDO SDI SCLK
    [sense_debug.kicad_pcb, sense_debug.kicad_sch]
2026-07-07 add debug software
    [sense_debug.kicad_pcb]
2026-07-14 update nfc sense ntag with attiny 1626
    [nfc_sense_ntag.kicad_pcb, nfc_sense_ntag.kicad_sch, sense_debug.kicad_sch]
2026-07-17 small DRC changes + silkscreen version info
    [nfc_sense_ntag.kicad_pcb, nfc_sense_ntag_panel.kicad_pcb]
2026-07-18 correct back silkscreen description
    [nfc_sense_ntag.kicad_pcb]
2026-07-24 add new BME version
    [nfc_sense_ntag_BME.kicad_pcb, nfc_sense_ntag_BME.kicad_sch, nfc_sense_ntag_BME.step]
2026-07-31 create new 3d models for flashing tool
    [nfc_sense_ntag.step, programming_case_0_8mm.FCStd, programming_case_ntag.FCStd]
2026-08-01 stencil helpers
    [stencil_spacers-Partrect_spacer.stl, stencil_spacers-Partround_spacer.stl, stencil_spacers.FCStd, stencilmate_spacers.FCStd]
2026-08-11 various 3D parts for stencil machine
    [nfc_sense_prgramming.kicad_pcb, programming_case_ntag-Body.stl, programming_case_ntag.FCStd, stencil_spacer_machine-PartBody.stl, stencil_spacer_machine.FCStd, stencil_spacers-Partrect_spacer.stl, stencil_spacers-Partround_spacer.stl, stencil_spacers.FCStd]
2026-08-13 implement ifdef for debugging, add variant switch for 117/116 versions, place logic in setup
    [nfc_case_simple_ntag-simple_case.stl, nfc_case_simple_ntag.FCStd, nfc_sense_ntag.step]
2026-09-10 update footprints with decreased paste
2026-11-02 remove silkscreen part names
